shannon-greenlight/pipes/pipes_sub/pipes_sub.kicad_pcb

## KiCad design pipes_sub/pipes_sub.kicad_pcb (2023-09-05)

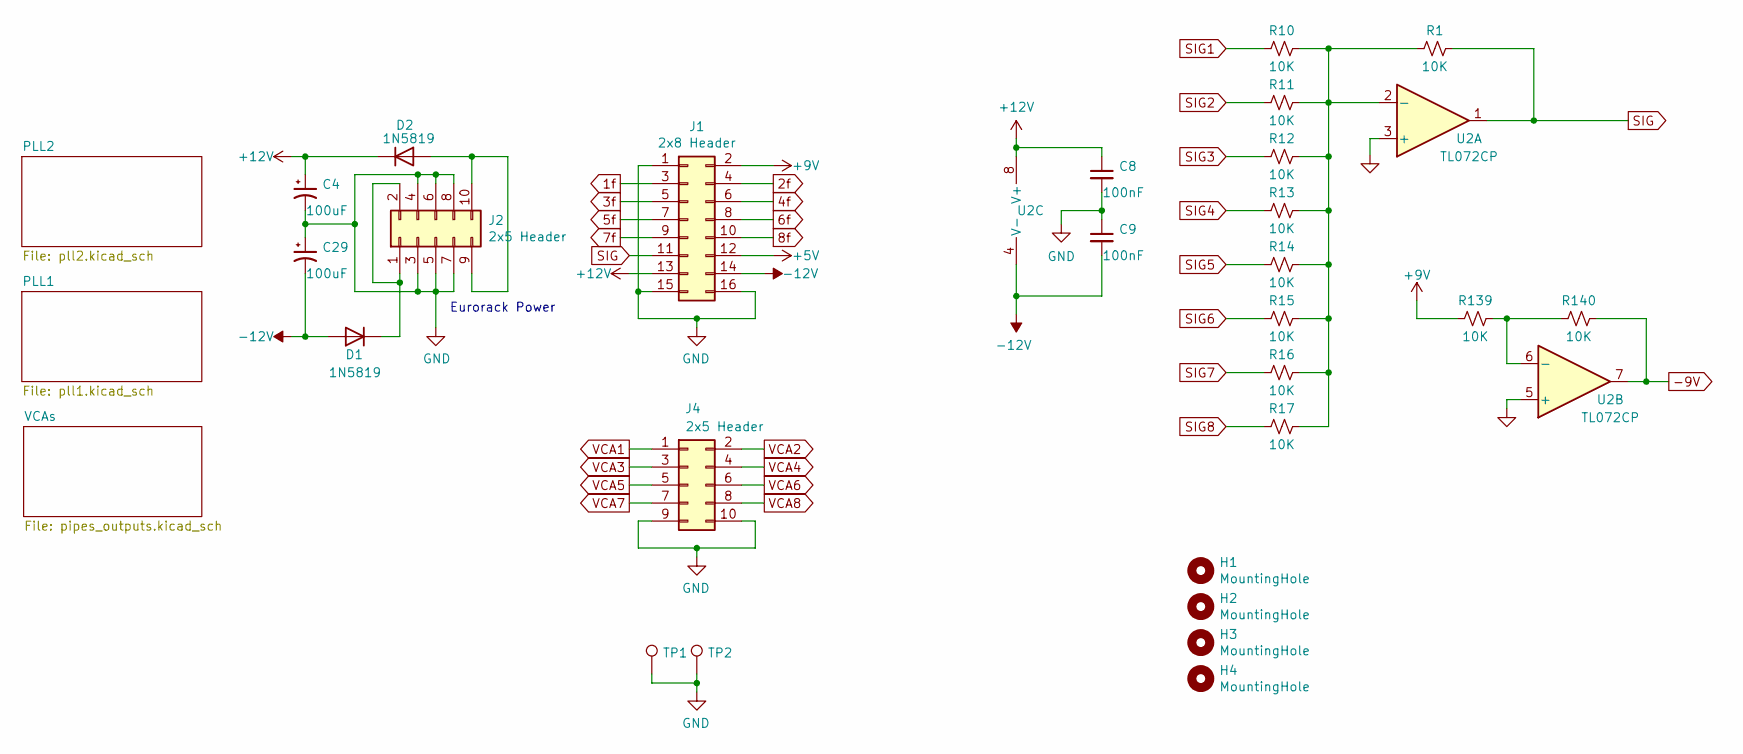
[picture p3: schematic pipes_sub.kicad_sch, Pipes]

Parts:
C4, C29: 100uF; CP_Elec_6.3x5.4_Nichicon; Digi-Key Part 399-EDH107M016A9GAACT-ND
C8, C9: 100nF; C_0805_2012Metric_Pad1.18x1.45mm_HandSolder; Digi-Key Part 478-10836-1-ND
D1, D2: 1N5819; D_SOD-323_HandSoldering; Digi-Key Part 478-7800-1-ND
H1, H2, H3, H4: MountingHole; MountingHole_2.5mm
J1: 2x8 Header; PinHeader_2x08_P2.54mm_Vertical_SMD; Digi-Key Part 732-5385-1-ND
J2: 2x5 Header; PinHeader_2x05_P2.54mm_Vertical_SMD; LCSC Part # C124391
J4: 2x5 Header; PinHeader_2x05_P2.54mm_Vertical_SMD; Digi-Key Part 732-5382-1-ND
R1, R10, R11, R12, R13, R14, R15, R16, R17, R139, R140: 10K; R_0603_1608Metric; Digi-Key Part CRT0805-FZ-1002ELFCT-ND
TP1, TP2: TestPoint; TestPoint_Keystone_5005-5009_Compact; Digi-Key Part 36-5006-ND
U2: TL072CP; SOIC-8_3.9x4.9mm_P1.27mm; Digi-Key Part 296-1775-5-ND

Connections:
1f: J1.3; also elsewhere on the board
2f: J1.4; also elsewhere on the board
3f: J1.5; also elsewhere on the board
4f: J1.6; also elsewhere on the board
5f: J1.7; also elsewhere on the board
6f: J1.8; also elsewhere on the board
7f: J1.9; also elsewhere on the board
8f: J1.10; also elsewhere on the board
+5V: J1.12
+9V: J1.2, R139.2; also elsewhere on the board
+12V: C4.1, C8.1, D2.1 (K), J1.13, U2.8 (V+); also elsewhere on the board
-9V: R140.1, U2.7; also elsewhere on the board
-12V: C9.2, C29.2, D1.2 (A), J1.14, U2.4 (V-); also elsewhere on the board
GND: C4.2, C8.2, C9.1, C29.1, J1.1, J1.15, J1.16, J2.3, J2.4, J2.5, J2.6, J2.7, J2.8, J4.9, J4.10, TP1.1, TP2.1, U2.3 (+), U2.5 (+); also elsewhere on the board
unnamed: D1.1 (K), J2.1, J2.2
unnamed: D2.2 (A), J2.9, J2.10
unnamed: R1.2, R10.1, R11.1, R12.1, R13.1, R14.1, R15.1, R16.1, R17.1, U2.2 (-)
unnamed: R139.1, R140.2, U2.6 (-)
SIG: J1.11, R1.1, U2.1
SIG1: R10.2; also elsewhere on the board
SIG2: R11.2; also elsewhere on the board
SIG3: R12.2; also elsewhere on the board
SIG4: R13.2; also elsewhere on the board
SIG5: R14.2; also elsewhere on the board
SIG6: R15.2; also elsewhere on the board
SIG7: R16.2; also elsewhere on the board
SIG8: R17.2; also elsewhere on the board
VCA1: J4.1; also elsewhere on the board
VCA2: J4.2; also elsewhere on the board
VCA3: J4.3; also elsewhere on the board
VCA4: J4.4; also elsewhere on the board
VCA5: J4.5; also elsewhere on the board
VCA6: J4.6; also elsewhere on the board
VCA7: J4.7; also elsewhere on the board
VCA8: J4.8; also elsewhere on the board

Notes on the sheet:
Eurorack Power

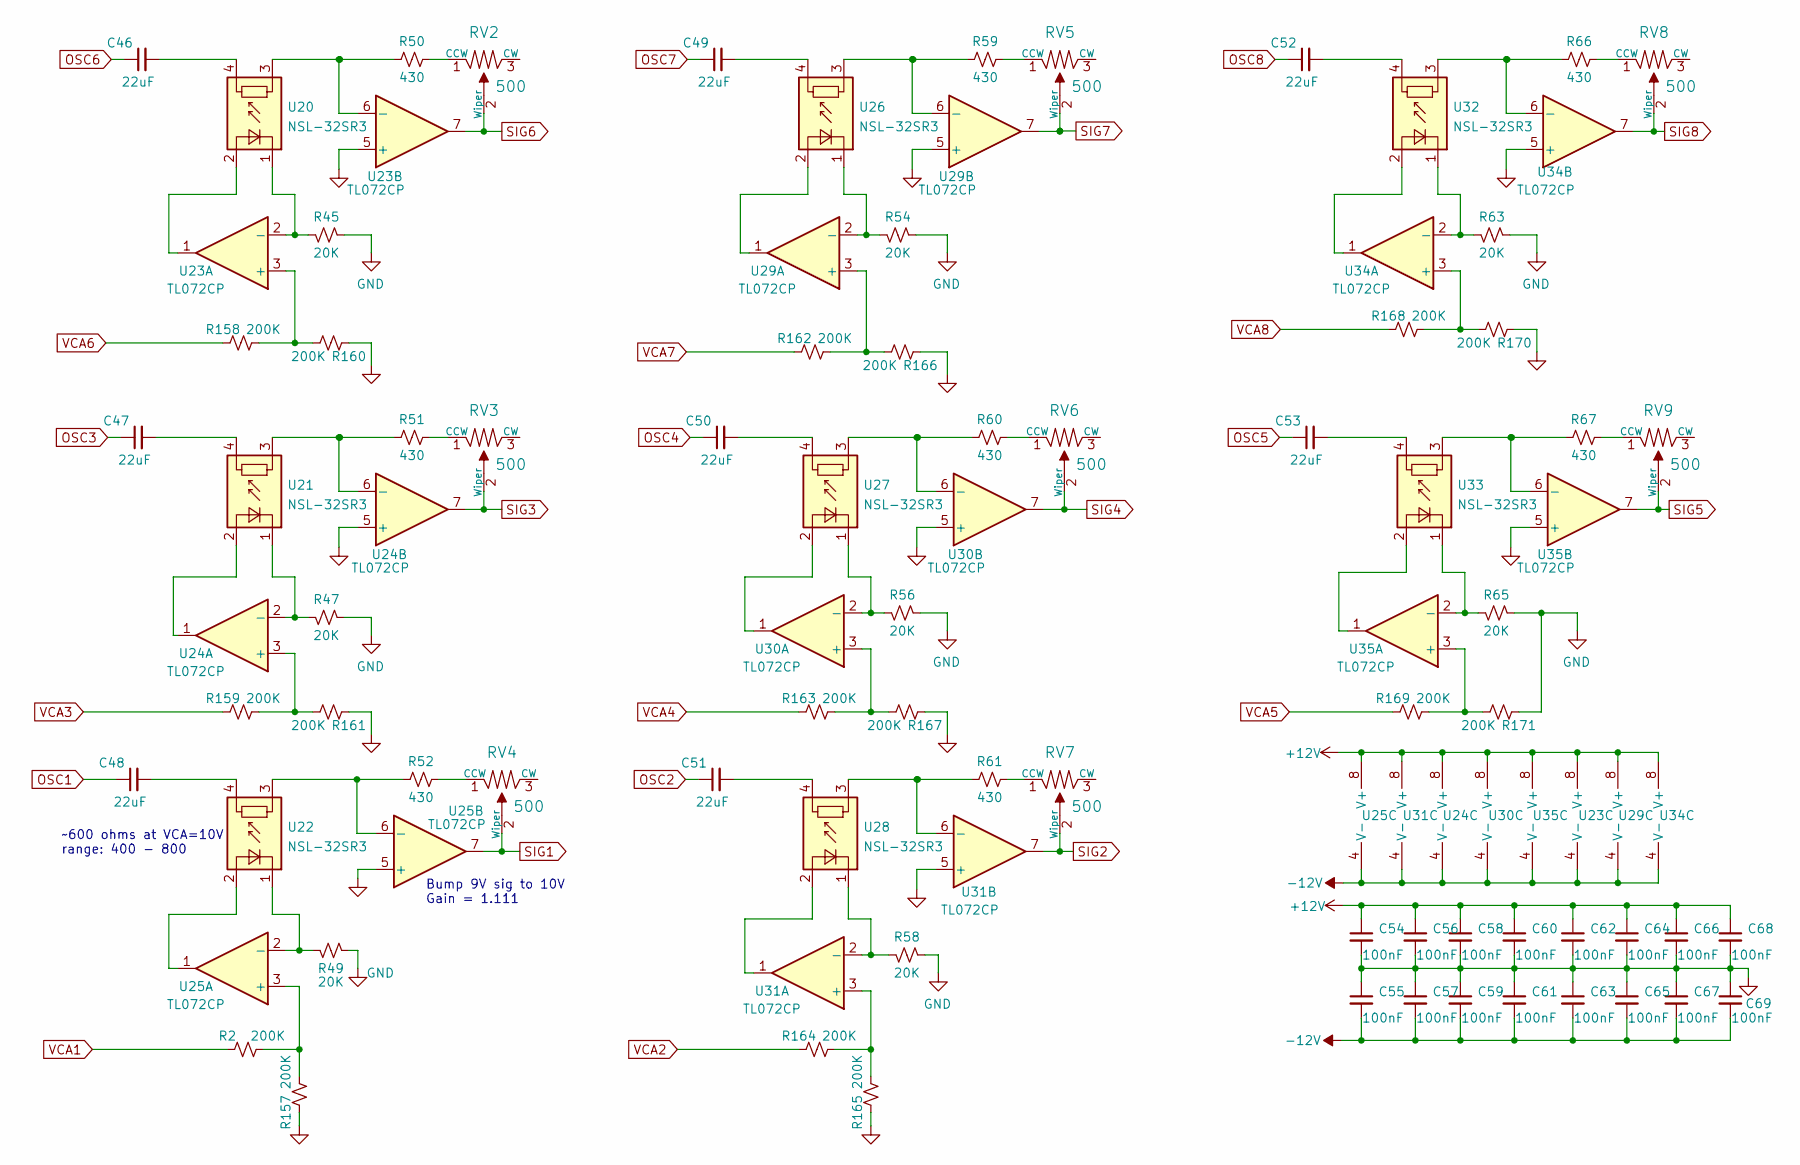
[picture p4: schematic pipes_outputs.kicad_sch, Pipes]

Parts:
C46, C47, C48, C49, C50, C51, C52, C53: 22uF; C_0805_2012Metric_Pad1.18x1.45mm_HandSolder; Digi-Key Part 478-10836-1-ND
C54, C55, C56, C57, C58, C59, C60, C61, C62, C63, C64, C65, C66, C67, C68, C69: 100nF; C_0805_2012Metric_Pad1.18x1.45mm_HandSolder; Digi-Key Part 478-10836-1-ND
R2, R157, R158, R159, R160, R161, R162, R163, R164, R165, R166, R167, R168, R169, R170, R171: 200K; R_0603_1608Metric; Digi-Key Part CF14JT10K0CT-ND
R45, R47, R49, R54, R56, R58, R63, R65: 20K; R_0603_1608Metric; Digi-Key Part CRT0805-FZ-1002ELFCT-ND
R50, R51, R52, R59, R60, R61, R66, R67: 430; R_0603_1608Metric; Digi-Key Part CRT0805-FZ-1002ELFCT-ND
RV2, RV3, RV4, RV5, RV6, RV7, RV8, RV9: 500; Potentiometer_Bourns_3224W_Vertical; LCSC Part # C116324
U20, U21, U22, U26, U27, U28, U32, U33: NSL-32SR3; PerkinElmer_VTL5C; Digi-Key Part NSL-32SR3-ND
U23, U24, U25, U29, U30, U31, U34: TL072CP; SOIC-8_3.9x4.9mm_P1.27mm; Digi-Key Part 296-1775-5-ND
U35: TL072CP; SOIC-8_3.9x4.9mm_P1.27mm; LCSC Part # C67473

Connections:
+12V: C54.1, C56.1, C58.1, C60.1, C62.1, C64.1, C66.1, C68.1, U23.8 (V+), U24.8 (V+), U25.8 (V+), U29.8 (V+), U30.8 (V+), U31.8 (V+), U34.8 (V+), U35.8 (V+); also elsewhere on the board
-12V: C55.2, C57.2, C59.2, C61.2, C63.2, C65.2, C67.2, C69.2, U23.4 (V-), U24.4 (V-), U25.4 (V-), U29.4 (V-), U30.4 (V-), U31.4 (V-), U34.4 (V-), U35.4 (V-); also elsewhere on the board
GND: C54.2, C55.1, C56.2, C57.1, C58.2, C59.1, C60.2, C61.1, C62.2, C63.1, C64.2, C65.1, C66.2, C67.1, C68.2, C69.1, R45.2, R47.2, R49.2, R54.2, R56.2, R58.2, R63.2, R65.2, R157.1, R160.1, R161.1, R165.1, R166.1, R167.1, R170.1, R171.1, U23.5 (+), U24.5 (+), U25.5 (+), U29.5 (+), U30.5 (+), U31.5 (+), U34.5 (+), U35.5 (+); also elsewhere on the board
unnamed: C49.2, U26.4
unnamed: C50.2, U27.4
unnamed: C53.2, U33.4
unnamed: R45.1, U20.1 (-), U23.2 (-)
unnamed: R47.1, U21.1 (-), U24.2 (-)
unnamed: R49.1, U22.1 (-), U25.2 (-)
unnamed: R50.1, RV2.1 (CCW)
unnamed: R50.2, U20.3, U23.6 (-)
unnamed: R51.1, RV3.1 (CCW)
unnamed: R51.2, U21.3, U24.6 (-)
unnamed: R52.1, RV4.1 (CCW)
unnamed: R52.2, U22.3, U25.6 (-)
unnamed: R54.1, U26.1 (-), U29.2 (-)
unnamed: R56.1, U27.1 (-), U30.2 (-)
unnamed: R58.1, U28.1 (-), U31.2 (-)
unnamed: R59.1, RV5.1 (CCW)
unnamed: R59.2, U26.3, U29.6 (-)
unnamed: R60.1, RV6.1 (CCW)
unnamed: R60.2, U27.3, U30.6 (-)
unnamed: R61.1, RV7.1 (CCW)
unnamed: R61.2, U28.3, U31.6 (-)
unnamed: R63.1, U32.1 (-), U34.2 (-)
unnamed: R65.1, U33.1 (-), U35.2 (-)
unnamed: R66.1, RV8.1 (CCW)
unnamed: R66.2, U32.3, U34.6 (-)
unnamed: R67.1, RV9.1 (CCW)
unnamed: R67.2, U33.3, U35.6 (-)
unnamed: R2.2, R157.2, U25.3 (+)
unnamed: R158.2, R160.2, U23.3 (+)
unnamed: R159.2, R161.2, U24.3 (+)
unnamed: R162.2, R166.2, U29.3 (+)
unnamed: R163.2, R167.2, U30.3 (+)
unnamed: R164.2, R165.2, U31.3 (+)
unnamed: R168.2, R170.2, U34.3 (+)
unnamed: R169.2, R171.2, U35.3 (+)
unnamed: U20.2 (+), U23.1
unnamed: C46.2, U20.4
unnamed: U21.2 (+), U24.1
unnamed: C47.2, U21.4
unnamed: U22.2 (+), U25.1
unnamed: C48.2, U22.4
unnamed: U26.2 (+), U29.1
unnamed: U27.2 (+), U30.1
unnamed: U28.2 (+), U31.1
unnamed: C51.2, U28.4
unnamed: U32.2 (+), U34.1
unnamed: C52.2, U32.4
unnamed: U33.2 (+), U35.1
OSC1: C48.1; also elsewhere on the board
OSC2: C51.1; also elsewhere on the board
OSC3: C47.1; also elsewhere on the board
OSC4: C50.1; also elsewhere on the board
OSC5: C53.1; also elsewhere on the board
OSC6: C46.1; also elsewhere on the board
OSC7: C49.1; also elsewhere on the board
OSC8: C52.1; also elsewhere on the board
SIG1: RV4.2 (Wiper), U25.7; also elsewhere on the board
SIG2: RV7.2 (Wiper), U31.7; also elsewhere on the board
SIG3: RV3.2 (Wiper), U24.7; also elsewhere on the board
SIG4: RV6.2 (Wiper), U30.7; also elsewhere on the board
SIG5: RV9.2 (Wiper), U35.7; also elsewhere on the board
SIG6: RV2.2 (Wiper), U23.7; also elsewhere on the board
SIG7: RV5.2 (Wiper), U29.7; also elsewhere on the board
SIG8: RV8.2 (Wiper), U34.7; also elsewhere on the board
VCA1: R2.1; also elsewhere on the board
VCA2: R164.1; also elsewhere on the board
VCA3: R159.1; also elsewhere on the board
VCA4: R163.1; also elsewhere on the board
VCA5: R169.1; also elsewhere on the board
VCA6: R158.1; also elsewhere on the board
VCA7: R162.1; also elsewhere on the board
VCA8: R168.1; also elsewhere on the board

Notes on the sheet:
Bump 9V sig to 10V Gain = 1.111
~600 ohms at VCA=10V range: 400 - 800

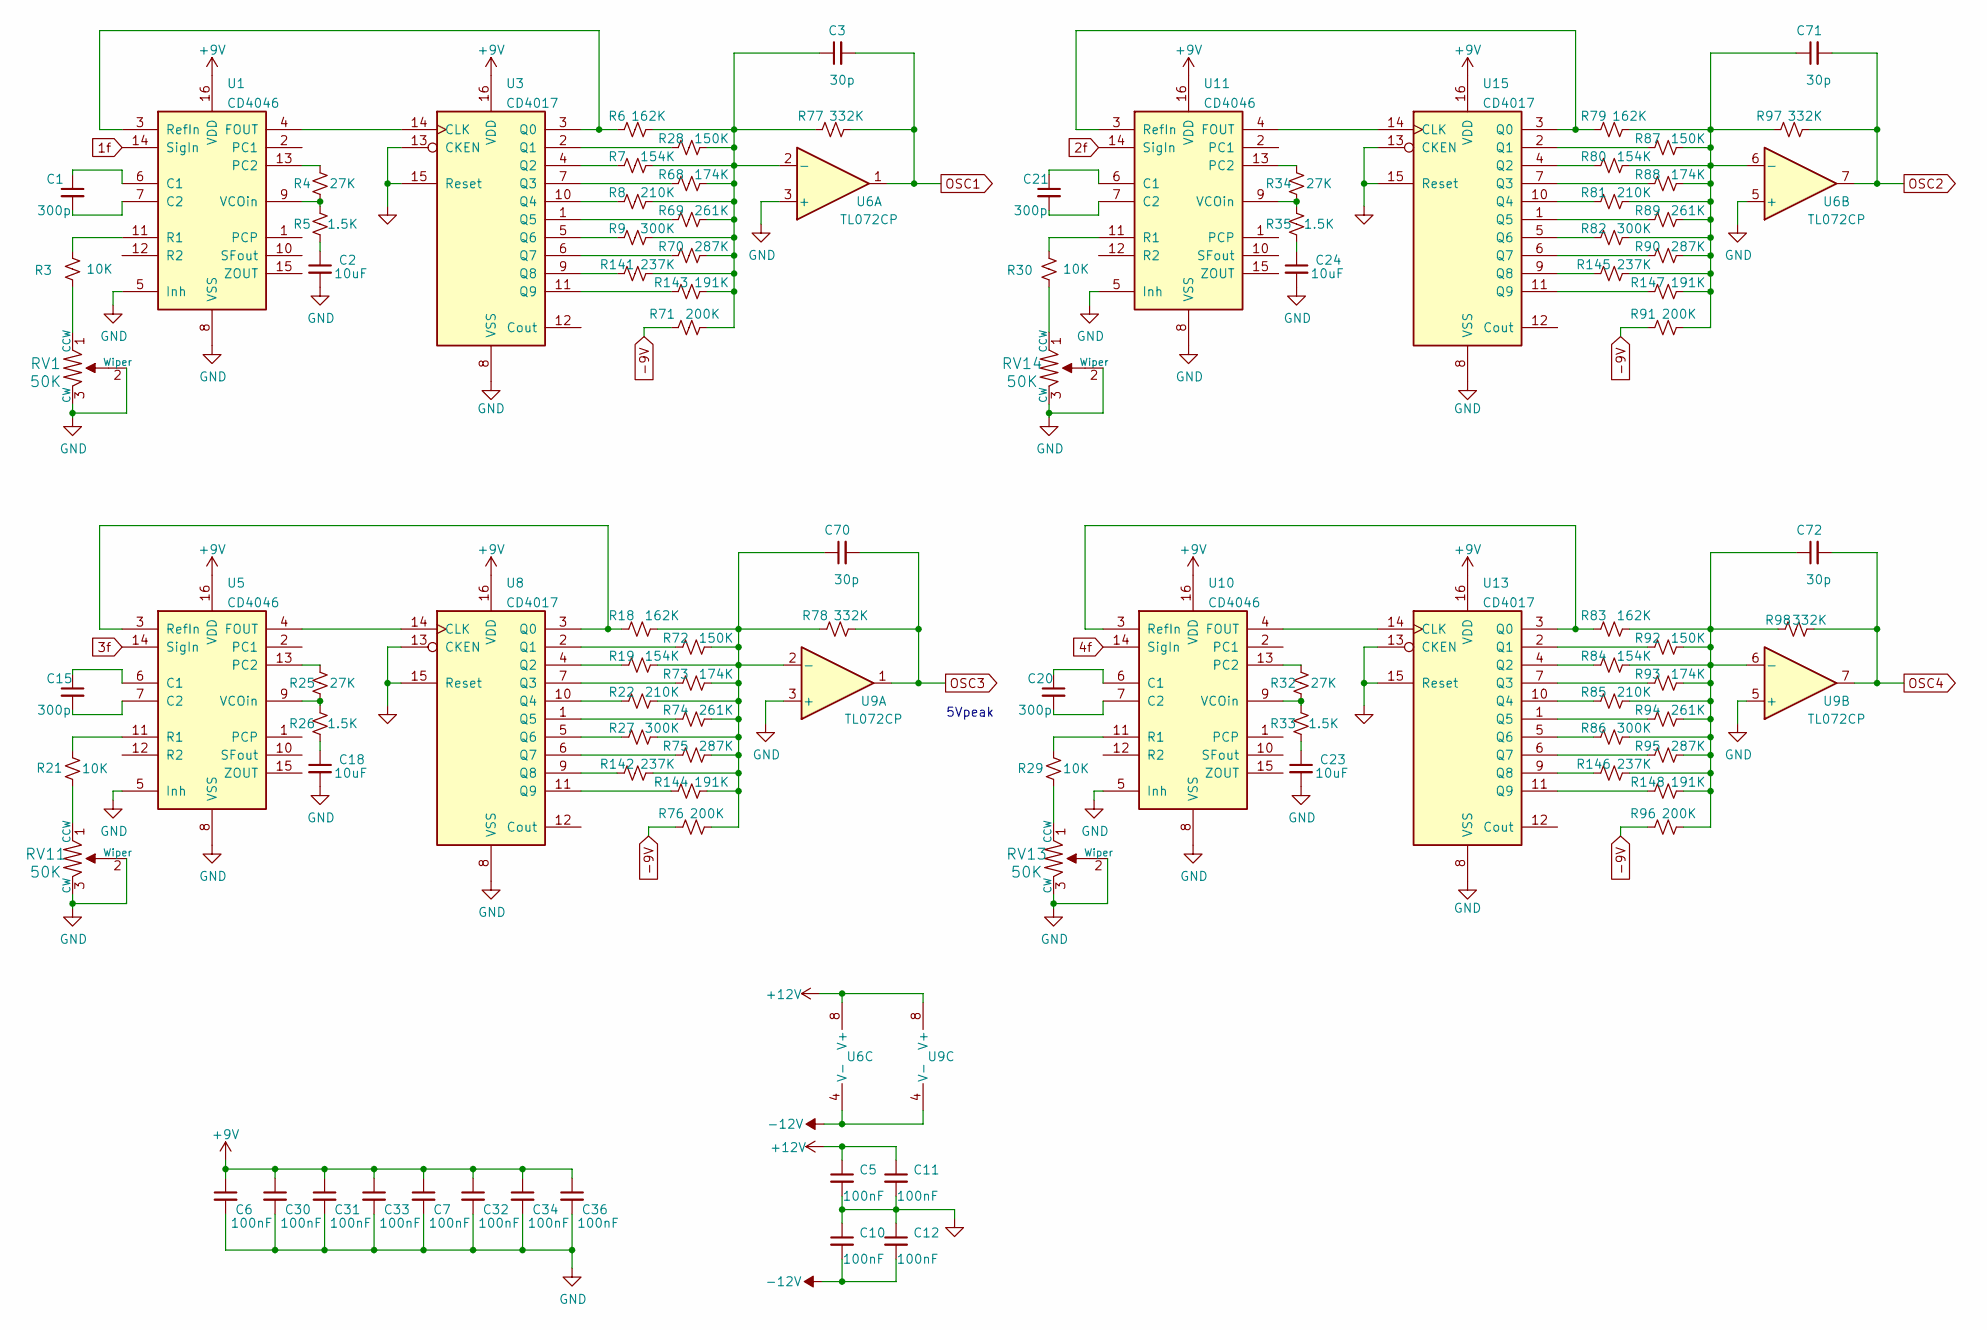
[picture p5: schematic pll1.kicad_sch, Pipes]

Parts:
C1, C15, C20, C21: 300p; C_0805_2012Metric_Pad1.18x1.45mm_HandSolder; Digi-Key Part BC2662CT-ND
C2, C18, C23, C24: 10uF; C_0805_2012Metric_Pad1.18x1.45mm_HandSolder; Digi-Key Part 478-10836-1-ND
C3, C70, C71, C72: 30p; C_0805_2012Metric_Pad1.18x1.45mm_HandSolder; Digi-Key Part BC2662CT-ND
C5, C6, C7, C10, C11, C12, C30, C31, C32, C33, C34, C36: 100nF; C_0805_2012Metric_Pad1.18x1.45mm_HandSolder; Digi-Key Part 478-10836-1-ND
R3, R21, R29, R30: 10K; R_0603_1608Metric; Digi-Key Part CF14JT10K0CT-ND
R4, R25, R32, R34: 27K; R_0805_2012Metric_Pad1.20x1.40mm_HandSolder; Digi-Key Part CF14JT10K0CT-ND
R5, R26, R33, R35: 1.5K; R_0805_2012Metric_Pad1.20x1.40mm_HandSolder; Digi-Key Part CF14JT10K0CT-ND
R6, R18, R79, R83: 162K; R_0603_1608Metric; Digi-Key Part CF14JT10K0CT-ND
R7, R19, R80, R84: 154K; R_0603_1608Metric; Digi-Key Part CF14JT10K0CT-ND
R8, R22, R81, R85: 210K; R_0603_1608Metric; Digi-Key Part CF14JT10K0CT-ND
R9, R27, R82, R86: 300K; R_0603_1608Metric; Digi-Key Part CF14JT10K0CT-ND
R28, R72, R87, R92: 150K; R_0603_1608Metric; Digi-Key Part CF14JT10K0CT-ND
R68, R73, R88, R93: 174K; R_0603_1608Metric; Digi-Key Part CF14JT10K0CT-ND
R69, R74, R89, R94: 261K; R_0603_1608Metric; Digi-Key Part CF14JT10K0CT-ND
R70, R75, R90, R95: 287K; R_0603_1608Metric; Digi-Key Part CF14JT10K0CT-ND
R71, R76, R91, R96: 200K; R_0603_1608Metric; Digi-Key Part CF14JT10K0CT-ND
R77, R78, R97, R98: 332K; R_0603_1608Metric; Digi-Key Part CF14JT10K0CT-ND
R141, R142, R145, R146: 237K; R_0603_1608Metric; Digi-Key Part CF14JT10K0CT-ND
R143, R144, R147, R148: 191K; R_0603_1608Metric; Digi-Key Part CF14JT10K0CT-ND
RV1, RV11, RV13, RV14: 50K; Potentiometer_Bourns_3224W_Vertical; Digi-Key Part 490-2881-ND
U1, U5, U10, U11: CD4046; TSSOP-16_4.4x5mm_P0.65mm; LCSC Part # C2651240
U3, U8, U13, U15: CD4017; SOIC-16_3.9x9.9mm_P1.27mm; Digi-Key Part 296-12808-1-ND
U6: TL072CP; SOIC-8_3.9x4.9mm_P1.27mm; Digi-Key Part 296-1775-5-ND
U9: TL072CP; SOIC-8_3.9x4.9mm_P1.27mm; LCSC Part # C67473

Connections:
1f: U1.14 (SigIn); also elsewhere on the board
2f: U11.14 (SigIn); also elsewhere on the board
3f: U5.14 (SigIn); also elsewhere on the board
4f: U10.14 (SigIn); also elsewhere on the board
+9V: C6.1, C7.1, C30.1, C31.1, C32.1, C33.1, C34.1, C36.1, U1.16 (VDD), U3.16 (VDD), U5.16 (VDD), U8.16 (VDD), U10.16 (VDD), U11.16 (VDD), U13.16 (VDD), U15.16 (VDD); also elsewhere on the board
+12V: C5.1, C11.1, U6.8 (V+), U9.8 (V+); also elsewhere on the board
-9V: R71.1, R76.1, R91.1, R96.1; also elsewhere on the board
-12V: C10.2, C12.2, U6.4 (V-), U9.4 (V-); also elsewhere on the board
GND: C2.2, C5.2, C6.2, C7.2, C10.1, C11.2, C12.1, C18.2, C23.2, C24.2, C30.2, C31.2, C32.2, C33.2, C34.2, C36.2, RV1.2 (Wiper), RV1.3 (CW), RV11.2 (Wiper), RV11.3 (CW), RV13.2 (Wiper), RV13.3 (CW), RV14.2 (Wiper), RV14.3 (CW), U1.5 (Inh), U1.8 (VSS), U3.8 (VSS), U3.13 (CKEN), U3.15 (Reset), U5.5 (Inh), U5.8 (VSS), U6.3 (+), U6.5 (+), U8.8 (VSS), U8.13 (CKEN), U8.15 (Reset), U9.3 (+), U9.5 (+), U10.5 (Inh), U10.8 (VSS), U11.5 (Inh), U11.8 (VSS), U13.8 (VSS), U13.13 (CKEN), U13.15 (Reset), U15.8 (VSS), U15.13 (CKEN), U15.15 (Reset); also elsewhere on the board
unnamed: C1.1, U1.6 (C1)
unnamed: C1.2, U1.7 (C2)
unnamed: C2.1, R5.2
unnamed: C3.1, R6.2, R7.2, R8.2, R9.2, R28.2, R68.2, R69.2, R70.2, R71.2, R77.1, R141.2, R143.2, U6.2 (-)
unnamed: C15.1, U5.6 (C1)
unnamed: C15.2, U5.7 (C2)
unnamed: C18.1, R26.2
unnamed: C20.1, U10.6 (C1)
unnamed: C20.2, U10.7 (C2)
unnamed: C21.1, U11.6 (C1)
unnamed: C21.2, U11.7 (C2)
unnamed: C23.1, R33.2
unnamed: C24.1, R35.2
unnamed: C70.1, R18.2, R19.2, R22.2, R27.2, R72.2, R73.2, R74.2, R75.2, R76.2, R78.1, R142.2, R144.2, U9.2 (-)
unnamed: C71.1, R79.2, R80.2, R81.2, R82.2, R87.2, R88.2, R89.2, R90.2, R91.2, R97.1, R145.2, R147.2, U6.6 (-)
unnamed: C72.1, R83.2, R84.2, R85.2, R86.2, R92.2, R93.2, R94.2, R95.2, R96.2, R98.1, R146.2, R148.2, U9.6 (-)
unnamed: R3.1, U1.11 (R1)
unnamed: R3.2, RV1.1 (CCW)
unnamed: R4.1, U1.13 (PC2)
unnamed: R4.2, R5.1, U1.9 (VCOin)
unnamed: R6.1, U1.3 (RefIn), U3.3 (Q0)
unnamed: R7.1, U3.4 (Q2)
unnamed: R8.1, U3.10 (Q4)
unnamed: R9.1, U3.5 (Q6)
unnamed: R18.1, U5.3 (RefIn), U8.3 (Q0)
unnamed: R19.1, U8.4 (Q2)
unnamed: R21.1, U5.11 (R1)
unnamed: R21.2, RV11.1 (CCW)
unnamed: R22.1, U8.10 (Q4)
unnamed: R25.1, U5.13 (PC2)
unnamed: R25.2, R26.1, U5.9 (VCOin)
unnamed: R27.1, U8.5 (Q6)
unnamed: R28.1, U3.2 (Q1)
unnamed: R29.1, U10.11 (R1)
unnamed: R29.2, RV13.1 (CCW)
unnamed: R30.1, U11.11 (R1)
unnamed: R30.2, RV14.1 (CCW)
unnamed: R32.1, U10.13 (PC2)
unnamed: R32.2, R33.1, U10.9 (VCOin)
unnamed: R34.1, U11.13 (PC2)
unnamed: R34.2, R35.1, U11.9 (VCOin)
unnamed: R68.1, U3.7 (Q3)
unnamed: R69.1, U3.1 (Q5)
unnamed: R70.1, U3.6 (Q7)
unnamed: R72.1, U8.2 (Q1)
unnamed: R73.1, U8.7 (Q3)
unnamed: R74.1, U8.1 (Q5)
unnamed: R75.1, U8.6 (Q7)
unnamed: R79.1, U11.3 (RefIn), U15.3 (Q0)
unnamed: R80.1, U15.4 (Q2)
unnamed: R81.1, U15.10 (Q4)
unnamed: R82.1, U15.5 (Q6)
unnamed: R83.1, U10.3 (RefIn), U13.3 (Q0)
unnamed: R84.1, U13.4 (Q2)
unnamed: R85.1, U13.10 (Q4)
unnamed: R86.1, U13.5 (Q6)
unnamed: R87.1, U15.2 (Q1)
unnamed: R88.1, U15.7 (Q3)
unnamed: R89.1, U15.1 (Q5)
unnamed: R90.1, U15.6 (Q7)
unnamed: R92.1, U13.2 (Q1)
unnamed: R93.1, U13.7 (Q3)
unnamed: R94.1, U13.1 (Q5)
unnamed: R95.1, U13.6 (Q7)
unnamed: R141.1, U3.9 (Q8)
unnamed: R142.1, U8.9 (Q8)
unnamed: R143.1, U3.11 (Q9)
unnamed: R144.1, U8.11 (Q9)
unnamed: R145.1, U15.9 (Q8)
unnamed: R146.1, U13.9 (Q8)
unnamed: R147.1, U15.11 (Q9)
unnamed: R148.1, U13.11 (Q9)
unnamed: U1.4 (FOUT), U3.14 (CLK)
unnamed: U5.4 (FOUT), U8.14 (CLK)
unnamed: U10.4 (FOUT), U13.14 (CLK)
unnamed: U11.4 (FOUT), U15.14 (CLK)
OSC1: C3.2, R77.2, U6.1; also elsewhere on the board
OSC2: C71.2, R97.2, U6.7; also elsewhere on the board
OSC3: C70.2, R78.2, U9.1; also elsewhere on the board
OSC4: C72.2, R98.2, U9.7; also elsewhere on the board

Notes on the sheet:
5Vpeak
