shannon-greenlight/pipes/pipes_sub/pipes_sub.kicad_pcb

## KiCad design pipes_sub/pipes_sub.kicad_pcb (continued)

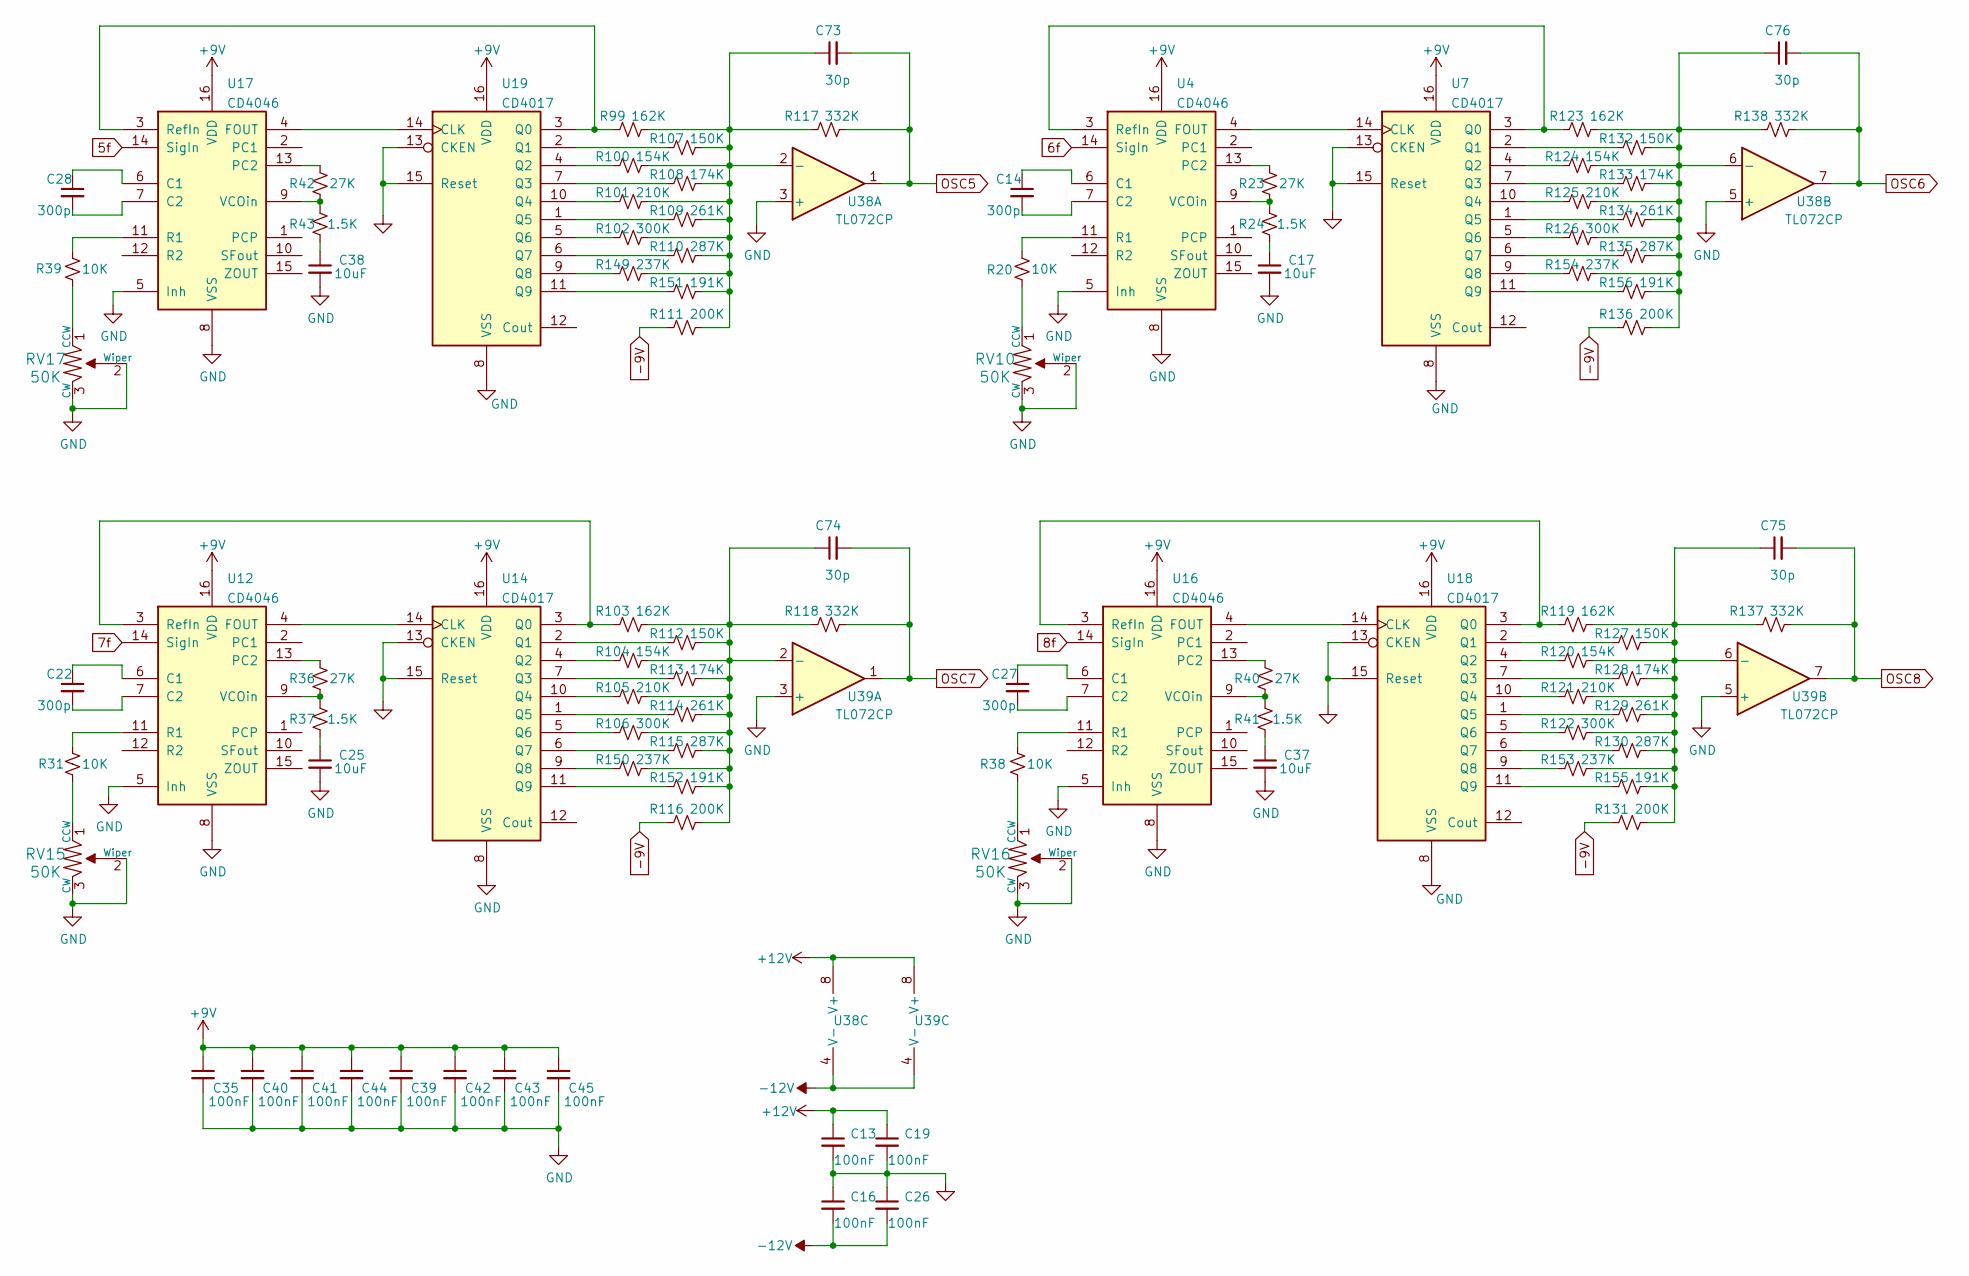
[picture p6: schematic pll2.kicad_sch, Pipes]

Parts:
C13, C16, C19, C26, C35, C39, C40, C41, C42, C43, C44, C45: 100nF; C_0805_2012Metric_Pad1.18x1.45mm_HandSolder; Digi-Key Part 478-10836-1-ND
C14, C22, C27, C28: 300p; C_0805_2012Metric_Pad1.18x1.45mm_HandSolder; Digi-Key Part BC2662CT-ND
C17, C25, C37, C38: 10uF; C_0805_2012Metric_Pad1.18x1.45mm_HandSolder; Digi-Key Part 478-10836-1-ND
C73, C74, C75, C76: 30p; C_0805_2012Metric_Pad1.18x1.45mm_HandSolder; Digi-Key Part BC2662CT-ND
R20, R31, R38, R39: 10K; R_0603_1608Metric; Digi-Key Part CF14JT10K0CT-ND
R23, R36, R40, R42: 27K; R_0805_2012Metric_Pad1.20x1.40mm_HandSolder; Digi-Key Part CF14JT10K0CT-ND
R24, R37, R41, R43: 1.5K; R_0805_2012Metric_Pad1.20x1.40mm_HandSolder; Digi-Key Part CF14JT10K0CT-ND
R99, R103, R119, R123: 162K; R_0603_1608Metric; Digi-Key Part CF14JT10K0CT-ND
R100, R104, R120, R124: 154K; R_0603_1608Metric; Digi-Key Part CF14JT10K0CT-ND
R101, R105, R121, R125: 210K; R_0603_1608Metric; Digi-Key Part CF14JT10K0CT-ND
R102, R106, R122, R126: 300K; R_0603_1608Metric; Digi-Key Part CF14JT10K0CT-ND
R107, R112, R127, R132: 150K; R_0603_1608Metric; Digi-Key Part CF14JT10K0CT-ND
R108, R113, R128, R133: 174K; R_0603_1608Metric; Digi-Key Part CF14JT10K0CT-ND
R109, R114, R129, R134: 261K; R_0603_1608Metric; Digi-Key Part CF14JT10K0CT-ND
R110, R115, R130, R135: 287K; R_0603_1608Metric; Digi-Key Part CF14JT10K0CT-ND
R111, R116, R131, R136: 200K; R_0603_1608Metric; Digi-Key Part CF14JT10K0CT-ND
R117, R118, R137, R138: 332K; R_0603_1608Metric; Digi-Key Part CF14JT10K0CT-ND
R149, R150, R153, R154: 237K; R_0603_1608Metric; Digi-Key Part CF14JT10K0CT-ND
R151, R152, R155, R156: 191K; R_0603_1608Metric; Digi-Key Part CF14JT10K0CT-ND
RV10, RV15, RV16, RV17: 50K; Potentiometer_Bourns_3224W_Vertical; Digi-Key Part 490-2881-ND
U4, U12, U16, U17: CD4046; TSSOP-16_4.4x5mm_P0.65mm; LCSC Part # C2651240
U7, U14, U18, U19: CD4017; SOIC-16_3.9x9.9mm_P1.27mm; Digi-Key Part 296-12808-1-ND
U38, U39: TL072CP; SOIC-8_3.9x4.9mm_P1.27mm; Digi-Key Part 296-1775-5-ND

Connections:
5f: U17.14 (SigIn); also elsewhere on the board
6f: U4.14 (SigIn); also elsewhere on the board
7f: U12.14 (SigIn); also elsewhere on the board
8f: U16.14 (SigIn); also elsewhere on the board
+9V: C35.1, C39.1, C40.1, C41.1, C42.1, C43.1, C44.1, C45.1, U4.16 (VDD), U7.16 (VDD), U12.16 (VDD), U14.16 (VDD), U16.16 (VDD), U17.16 (VDD), U18.16 (VDD), U19.16 (VDD); also elsewhere on the board
+12V: C13.1, C19.1, U38.8 (V+), U39.8 (V+); also elsewhere on the board
-9V: R111.1, R116.1, R131.1, R136.1; also elsewhere on the board
-12V: C16.2, C26.2, U38.4 (V-), U39.4 (V-); also elsewhere on the board
GND: C13.2, C16.1, C17.2, C19.2, C25.2, C26.1, C35.2, C37.2, C38.2, C39.2, C40.2, C41.2, C42.2, C43.2, C44.2, C45.2, RV10.2 (Wiper), RV10.3 (CW), RV15.2 (Wiper), RV15.3 (CW), RV16.2 (Wiper), RV16.3 (CW), RV17.2 (Wiper), RV17.3 (CW), U4.5 (Inh), U4.8 (VSS), U7.8 (VSS), U7.13 (CKEN), U7.15 (Reset), U12.5 (Inh), U12.8 (VSS), U14.8 (VSS), U14.13 (CKEN), U14.15 (Reset), U16.5 (Inh), U16.8 (VSS), U17.5 (Inh), U17.8 (VSS), U18.8 (VSS), U18.13 (CKEN), U18.15 (Reset), U19.8 (VSS), U19.13 (CKEN), U19.15 (Reset), U38.3 (+), U38.5 (+), U39.3 (+), U39.5 (+); also elsewhere on the board
unnamed: C14.1, U4.6 (C1)
unnamed: C14.2, U4.7 (C2)
unnamed: C17.1, R24.2
unnamed: C22.1, U12.6 (C1)
unnamed: C22.2, U12.7 (C2)
unnamed: C25.1, R37.2
unnamed: C27.1, U16.6 (C1)
unnamed: C27.2, U16.7 (C2)
unnamed: C28.1, U17.6 (C1)
unnamed: C28.2, U17.7 (C2)
unnamed: C37.1, R41.2
unnamed: C38.1, R43.2
unnamed: C73.1, R99.2, R100.2, R101.2, R102.2, R107.2, R108.2, R109.2, R110.2, R111.2, R117.1, R149.2, R151.2, U38.2 (-)
unnamed: C74.1, R103.2, R104.2, R105.2, R106.2, R112.2, R113.2, R114.2, R115.2, R116.2, R118.1, R150.2, R152.2, U39.2 (-)
unnamed: C75.1, R119.2, R120.2, R121.2, R122.2, R127.2, R128.2, R129.2, R130.2, R131.2, R137.1, R153.2, R155.2, U39.6 (-)
unnamed: C76.1, R123.2, R124.2, R125.2, R126.2, R132.2, R133.2, R134.2, R135.2, R136.2, R138.1, R154.2, R156.2, U38.6 (-)
unnamed: R20.1, U4.11 (R1)
unnamed: R20.2, RV10.1 (CCW)
unnamed: R23.1, U4.13 (PC2)
unnamed: R23.2, R24.1, U4.9 (VCOin)
unnamed: R31.1, U12.11 (R1)
unnamed: R31.2, RV15.1 (CCW)
unnamed: R36.1, U12.13 (PC2)
unnamed: R36.2, R37.1, U12.9 (VCOin)
unnamed: R38.1, U16.11 (R1)
unnamed: R38.2, RV16.1 (CCW)
unnamed: R39.1, U17.11 (R1)
unnamed: R39.2, RV17.1 (CCW)
unnamed: R40.1, U16.13 (PC2)
unnamed: R40.2, R41.1, U16.9 (VCOin)
unnamed: R42.1, U17.13 (PC2)
unnamed: R42.2, R43.1, U17.9 (VCOin)
unnamed: R99.1, U17.3 (RefIn), U19.3 (Q0)
unnamed: R100.1, U19.4 (Q2)
unnamed: R101.1, U19.10 (Q4)
unnamed: R102.1, U19.5 (Q6)
unnamed: R103.1, U12.3 (RefIn), U14.3 (Q0)
unnamed: R104.1, U14.4 (Q2)
unnamed: R105.1, U14.10 (Q4)
unnamed: R106.1, U14.5 (Q6)
unnamed: R107.1, U19.2 (Q1)
unnamed: R108.1, U19.7 (Q3)
unnamed: R109.1, U19.1 (Q5)
unnamed: R110.1, U19.6 (Q7)
unnamed: R112.1, U14.2 (Q1)
unnamed: R113.1, U14.7 (Q3)
unnamed: R114.1, U14.1 (Q5)
unnamed: R115.1, U14.6 (Q7)
unnamed: R119.1, U16.3 (RefIn), U18.3 (Q0)
unnamed: R120.1, U18.4 (Q2)
unnamed: R121.1, U18.10 (Q4)
unnamed: R122.1, U18.5 (Q6)
unnamed: R123.1, U4.3 (RefIn), U7.3 (Q0)
unnamed: R124.1, U7.4 (Q2)
unnamed: R125.1, U7.10 (Q4)
unnamed: R126.1, U7.5 (Q6)
unnamed: R127.1, U18.2 (Q1)
unnamed: R128.1, U18.7 (Q3)
unnamed: R129.1, U18.1 (Q5)
unnamed: R130.1, U18.6 (Q7)
unnamed: R132.1, U7.2 (Q1)
unnamed: R133.1, U7.7 (Q3)
unnamed: R134.1, U7.1 (Q5)
unnamed: R135.1, U7.6 (Q7)
unnamed: R149.1, U19.9 (Q8)
unnamed: R150.1, U14.9 (Q8)
unnamed: R151.1, U19.11 (Q9)
unnamed: R152.1, U14.11 (Q9)
unnamed: R153.1, U18.9 (Q8)
unnamed: R154.1, U7.9 (Q8)
unnamed: R155.1, U18.11 (Q9)
unnamed: R156.1, U7.11 (Q9)
unnamed: U4.4 (FOUT), U7.14 (CLK)
unnamed: U12.4 (FOUT), U14.14 (CLK)
unnamed: U16.4 (FOUT), U18.14 (CLK)
unnamed: U17.4 (FOUT), U19.14 (CLK)
OSC5: C73.2, R117.2, U38.1; also elsewhere on the board
OSC6: C76.2, R138.2, U38.7; also elsewhere on the board
OSC7: C74.2, R118.2, U39.1; also elsewhere on the board
OSC8: C75.2, R137.2, U39.7; also elsewhere on the board

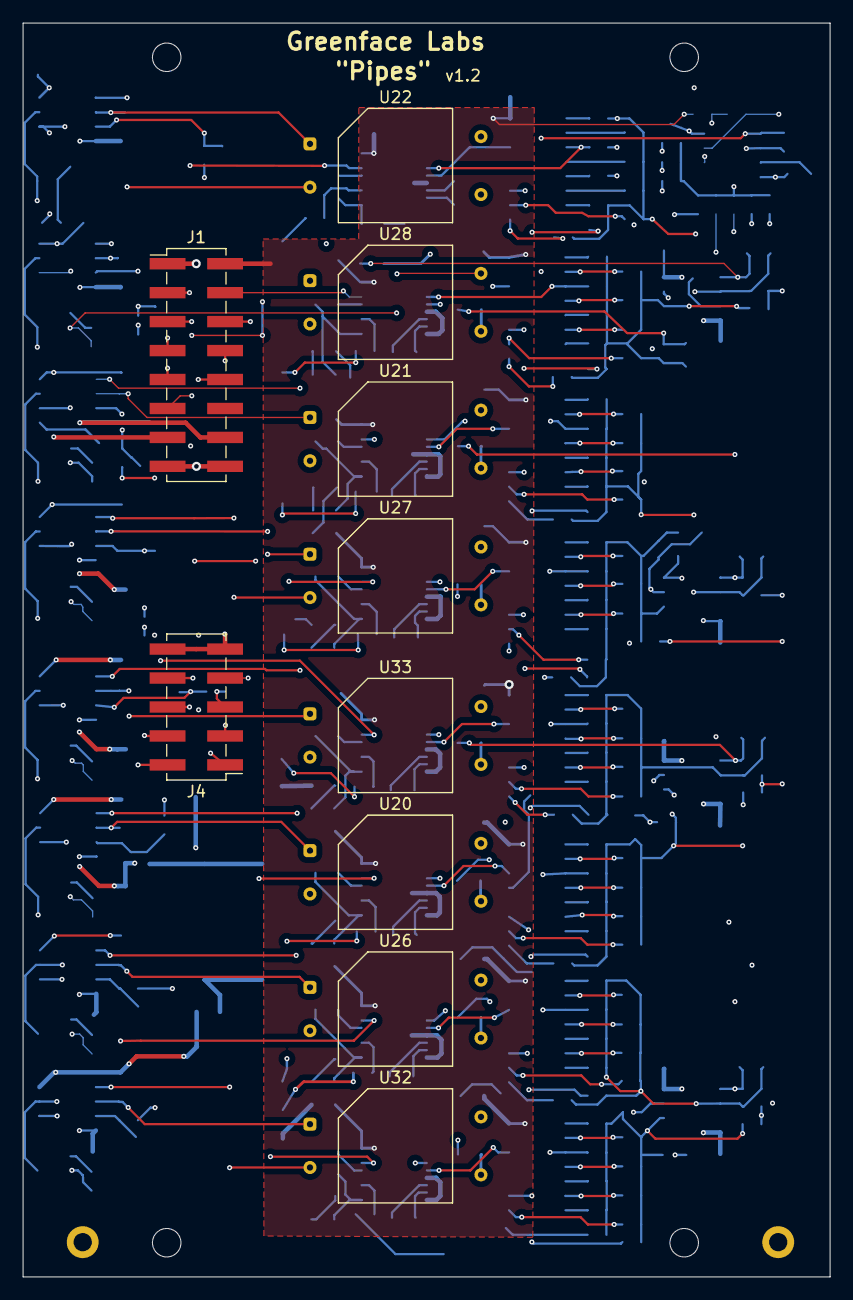
[picture p7: board pipes_sub.kicad_pcb from above]

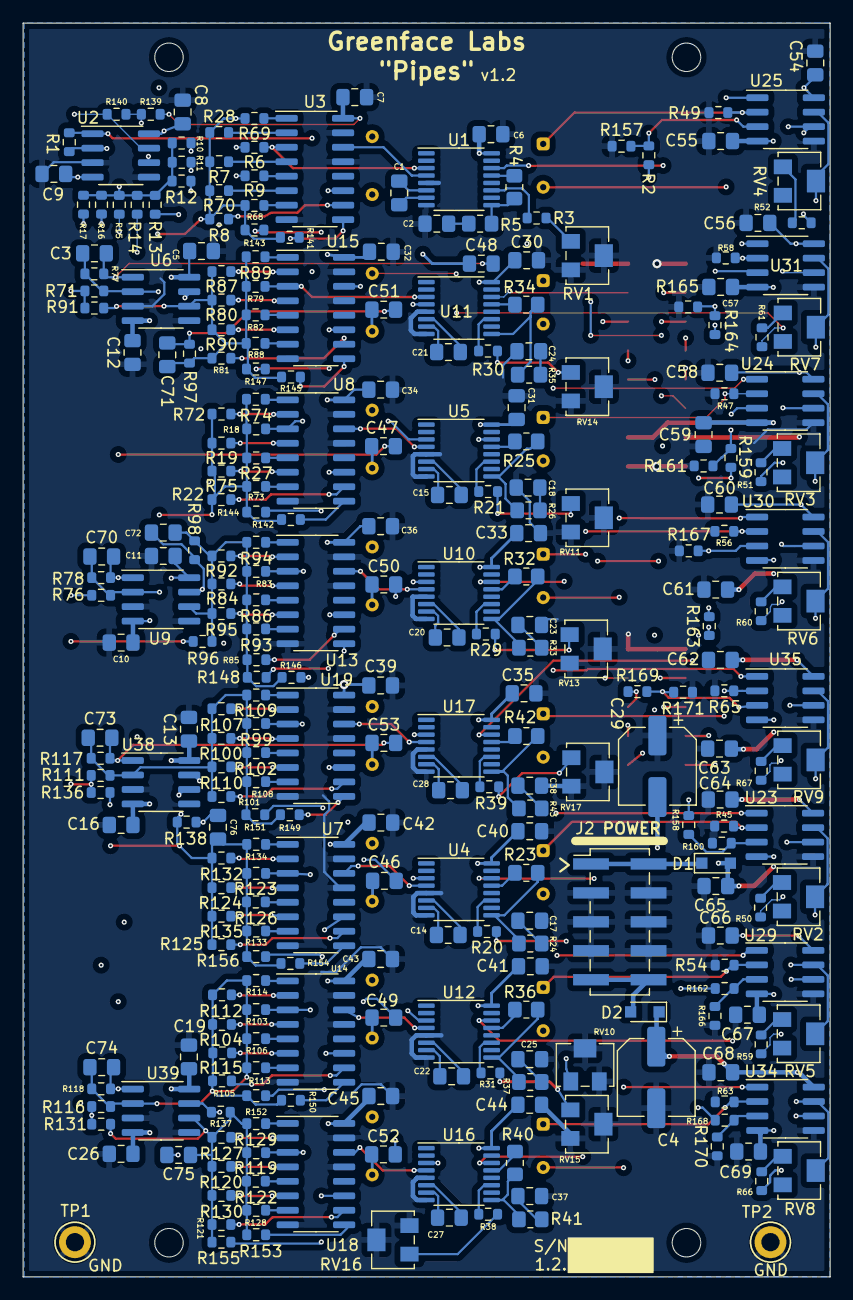
[picture p8: board pipes_sub.kicad_pcb from below]

Board: 4 copper layers, 70.8 x 110.0 mm, 303 parts (289 on the bottom side), 242 nets.
